Llcoolsouder/Comp-Arch-Processor/README.md

# Comp-Arch-Processor
This is the project for Rowan University's Computer Architecture class, ECE 09243 Section 3 Team l
under the Direction of Professor Michael Muhlbaier.

Our project is a Harvard architecture processor with tristate data buses.
See full documentation [here](Processor_Doc.pdf).

Team Members:  
        Lonnie L. Souder II  
        Jacob Epifano (https://github.com/jrepifano)  
	Sean McGuire (https://github.com/mcguires5)  
        Ardit Pranvoku  
        Ryan Drexel
