Llcoolsouder/Comp-Arch-Processor/(list of files, cad)

Other CAD files:
Seans Processor/simulation/modelsim/rtl_work/@a@l@u16bit_v/verilog.psm
Seans Processor/simulation/modelsim/rtl_work/@a@l@u_16bit_tb/verilog.psm
Seans Processor/simulation/modelsim/rtl_work/@full@adder/verilog.psm
Seans Processor/simulation/modelsim/rtl_work/decoder/verilog.psm
Seans Processor/simulation/modelsim/rtl_work/mux2to1/verilog.psm
Seans Processor/simulation/modelsim/rtl_work/mux3to8/verilog.psm
Seans Processor/simulation/modelsim/rtl_work/mux4to1/verilog.psm
Seans Processor/simulation/modelsim/rtl_work/reg16bit/verilog.psm
Seans Processor/simulation/modelsim/rtl_work/reg_file/verilog.psm
Seans Processor/simulation/modelsim/rtl_work/reg_file_tb/verilog.psm
simulation/modelsim/rtl_work/@a@l@u_16bit_t/verilog.psm
simulation/modelsim/rtl_work/@a@l@u_16bit_v/verilog.psm
simulation/modelsim/rtl_work/@a@l@u_4bit_v/verilog.psm
simulation/modelsim/rtl_work/@carry@lookahead@adder/verilog.psm
simulation/modelsim/rtl_work/@e@i@g@h@tto@o@n@e_@m@u@x16bit/verilog.psm
simulation/modelsim/rtl_work/@f@o@u@rto@o@n@e_@m@u@x/verilog.psm
simulation/modelsim/rtl_work/@i@r/verilog.psm
simulation/modelsim/rtl_work/@p@c/verilog.psm
simulation/modelsim/rtl_work/@r@a@m1/verilog.psm
simulation/modelsim/rtl_work/@register/verilog.psm
simulation/modelsim/rtl_work/@register@file_v/verilog.psm
simulation/modelsim/rtl_work/@register_@file_t/verilog.psm
simulation/modelsim/rtl_work/@register_@file_v/verilog.psm
simulation/modelsim/rtl_work/@t@h@r@e@eto@e@i@g@h@t_decoder/verilog.psm
simulation/modelsim/rtl_work/@t@w@oto@o@n@e_@m@u@x/verilog.psm
simulation/modelsim/rtl_work/@top_@level_@model@sim_v/verilog.psm
simulation/modelsim/rtl_work/@top_@level_@model@sim_v_t/verilog.psm
simulation/modelsim/rtl_work/and5_1/verilog.psm
simulation/modelsim/rtl_work/decoder/verilog.psm
simulation/modelsim/rtl_work/mux3to8/verilog.psm
simulation/modelsim/rtl_work/or5_0/verilog.psm
simulation/modelsim/rtl_work/reg16bit/verilog.psm
simulation/modelsim/rtl_work/rom_case/verilog.psm
simulation/modelsim/rtl_work/stack/verilog.psm
simulation/modelsim/rtl_work/stack_mux/verilog.psm
simulation/modelsim/rtl_work/status/verilog.psm
