Llcoolsouder/Comp-Arch-Processor/rom_case.v

module rom_case(out, PC); //10
    output reg[15:0] out;
    input [7:0] PC; //address- 8 deep memory
    
    always @(PC) begin
        case(PC)
//					 8'b00000000:		 out[15:0]<=16'b0100011111010010;//R7<-NOT R2
//              8'b00000001:      out[15:0]<=16'b1010111100000000;//Write R7 AD 0
//					 8'b00000010:      out[15:0]<=16'b0000000000000000;//1010111100000001;//Write R7 AD 1
//					 8'b00000011:      out[15:0]<=16'b1010111100000010;//Write R7 AD 2
//              8'b00000100:      out[15:0]<=16'b0000000000000000;//1010111100000011;//Write R7 AD 3
//              8'b00000101:      out[15:0]<=16'b1010111100000100;//Write R7 AD 4
//              8'b00000110:  	 out[15:0]<=16'b1010111100000101;//Write R7 AD 5
//              8'b00000111:      out[15:0]<=16'b1010111100000110;//Write R7 AD 6
//					 8'b00001000:		 out[15:0]<=16'b1010111100000111;//Write R7 AD 7
//					 8'b00001001 : 	 out[15:0]<=16'b1010000000000000;//LOADS MEMORY 0 INTO R0
//					 8'b00001010 : 	 out[15:0]<=16'b1010000100000001;//LOADS MEMORY 1 INTO R1
//					 8'b00001011 : 	 out[15:0]<=16'b1010001000000010;//LOADS MEMORY 2 INTO R2
//					 8'b00001100 : 	 out[15:0]<=16'b1010001100000011;//LOADS MEMORY 3 INTO R3
//					 8'b00001101 : 	 out[15:0]<=16'b1010010000000100;//LOADS MEMORY 4 INTO R4
//					 8'b00001110 : 	 out[15:0]<=16'b1010010100000101;//LOADS MEMORY 5 INTO R5
//					 8'b00001111 : 	 out[15:0]<=16'b1010011000000110;//LOADS MEMORY 6 INTO R6
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
		  
		  //STI
		  8'b00010111:  out[15:0]<=16'b1010111100000111; //Write R7 to AD 7
        
        //JUMPR
        8'b00011000 : out[15:0]<=16'b1001101011100111; //JUMP TO ADDRESS to 0
            
        default: out = 16'b0000000000000000; //NOP
        endcase
    end
endmodule // rom_case
