Llcoolsouder/Comp-Arch-Processor/clock_div.v

module clock_div(clk_in,clk_out);
	input clk_in;
	output clk_out;
	reg clk_out;
	reg [20:0] count;
	
	parameter MAX=1000000;
	
	always @(posedge clk_in) begin
		if(count >= MAX-1) begin
			count <= 0;
			clk_out <= ~clk_out;
		end
		else begin
			count <= count + 1'b1;
		end
	end	
endmodule
