Llcoolsouder/Comp-Arch-Processor/(commit log)

2017-02-09 The first step to a brighter tomorrow.
    [verilog.psm]
2017-02-09 Finished Register File Test Bench Inside Seans Processer folder
    [verilog.psm]
2017-02-09 Half of the ALU testbench
    [verilog.psm]
2017-02-09 Finished ALU testbench
    [verilog.psm]
2017-02-09 Working ALU test bench and stuff
    [verilog.psm]
2017-02-16 Pushing gpio and top lvl
    [verilog.psm]
2017-02-23 Lonnie saved the day on 2/23/17
    [verilog.psm]
2017-03-28 Fixed stack
    [verilog.psm]
2017-03-30 Demo 3-30-17, Sim
    [verilog.psm]
2017-04-25 Fixed Instructions and ROM
    [CPU_Decoder00.v, CPU_Decoder10.v, rom_case.v, status.v]
2017-05-07 testing GPIO buttons
